rrruark/ESP32_Radiosonde/radiosonde_lite_final.pdf

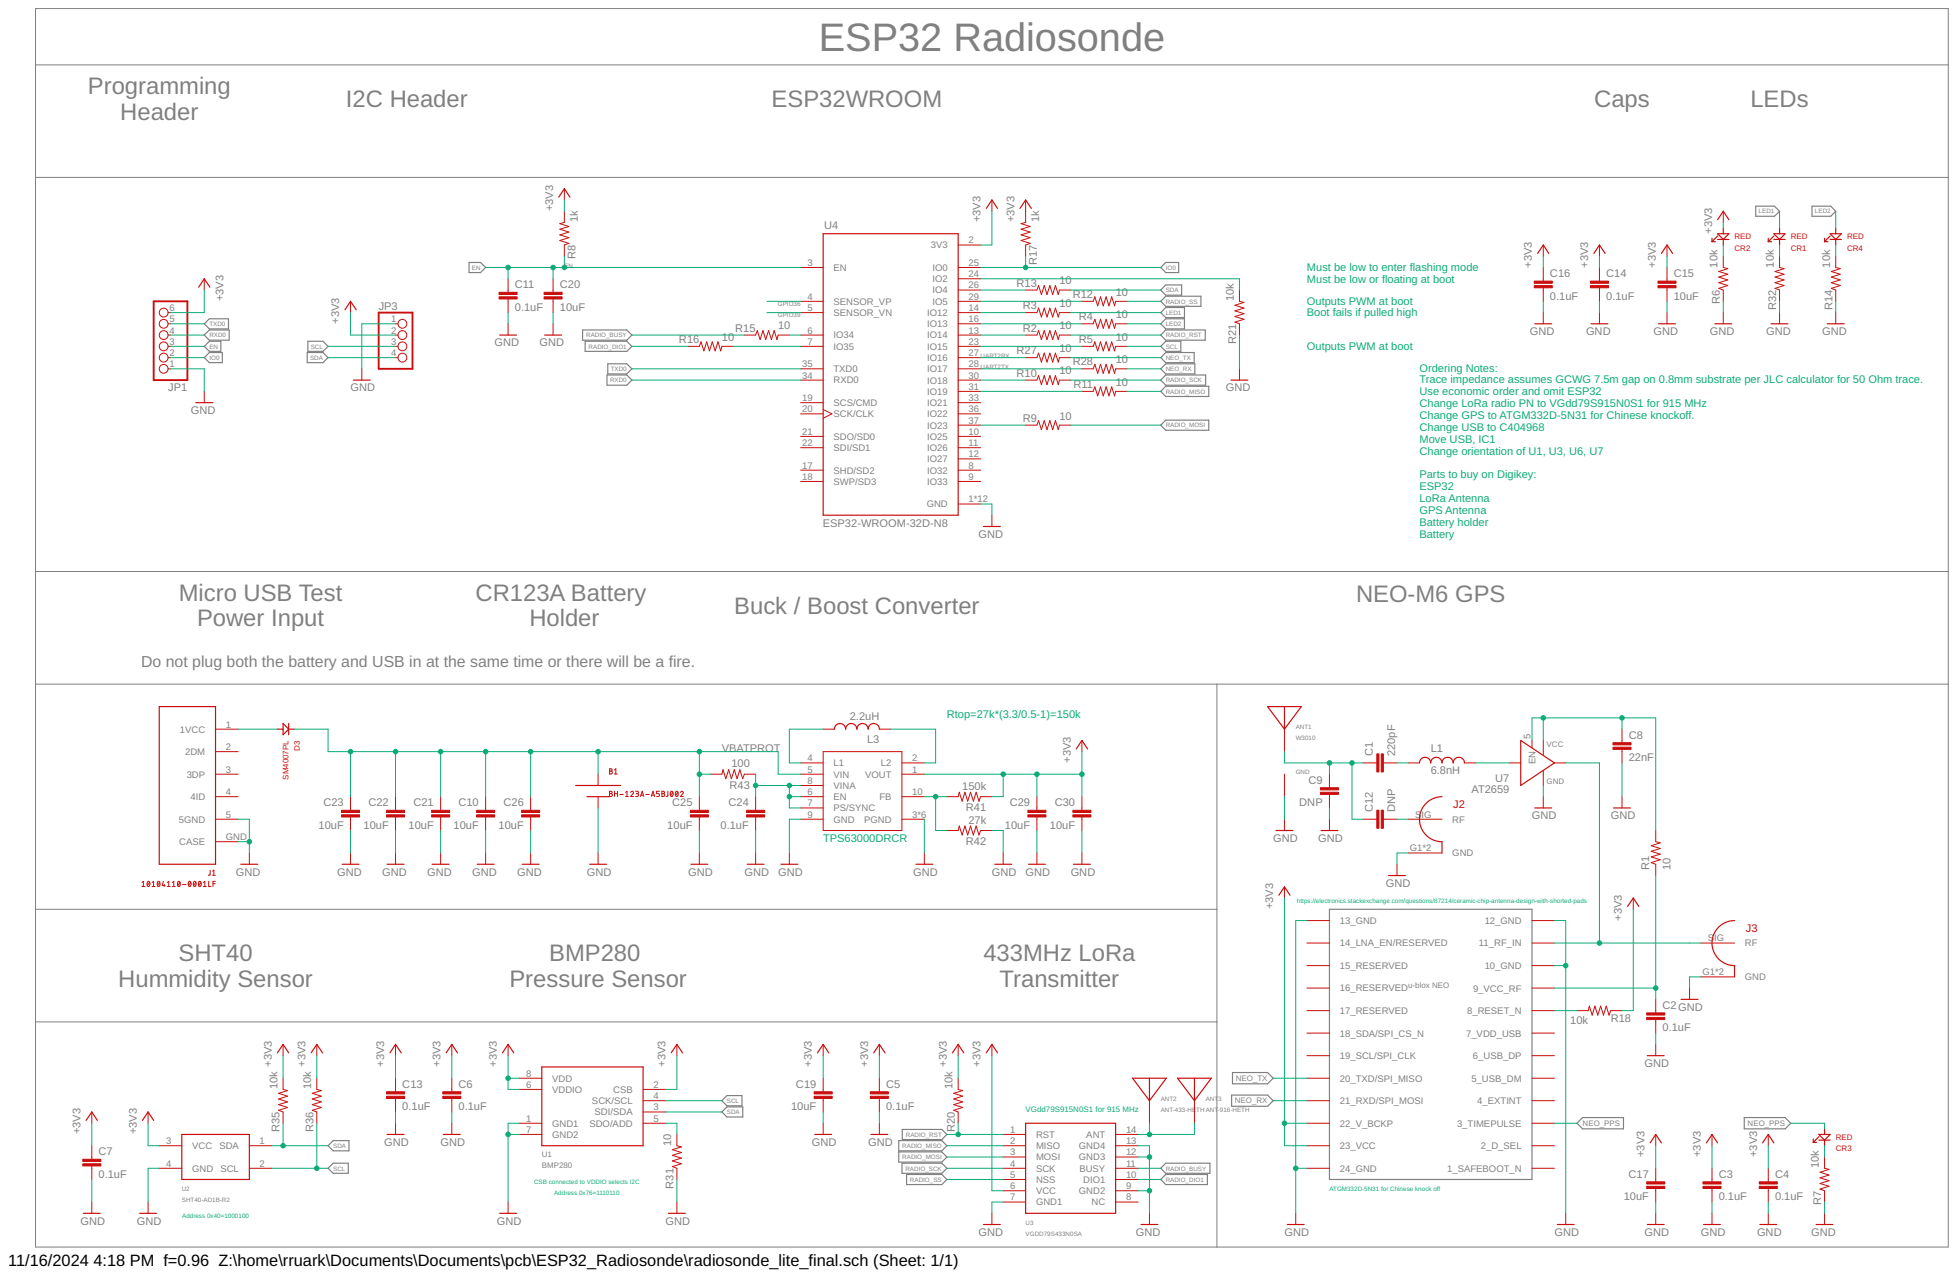
[picture p1: page 1]

Must be low or floating at boot Must be low to enter flashing mode Outputs PWM at boot Boot fails if pulled high

Outputs PWM at boot

Ordering Notes: Trace impedance assumes GCWG 7.5m gap on 0.8mm substrate per JLC calculator for 50 Ohm trace. Use economic order and omit ESP32

Change LoRa radio PN to VGdd79S915N0S1 for 915 MHz Change GPS to ATGM332D-5N31 for Chinese knockoff. Change USB to C404968

Parts to buy on Digikey: ESP32

LoRa Antenna GPS Antenna Battery holder Battery

Do not plug both the battery and USB in at the same time or there will be a fire.

https://electronics.stackexchange.com/questions/87214/ceramic-chip-antenna-design-with-shorted-pads

CSB connected to VDDIO selects I2C

ATGM332D-5N31 for Chinese knock off

11/16/2024 4:18 PM f=0.96 Z:\home\rruark\Documents\Documents\pcb\ESP32_Radiosonde\radiosonde_lite_final.sch (Sheet: 1/1)
