rrruark/ESP32_Radiosonde/PCB/radiosonde_lite.brd

## EAGLE design PCB/radiosonde_lite.brd (2024-10-17)

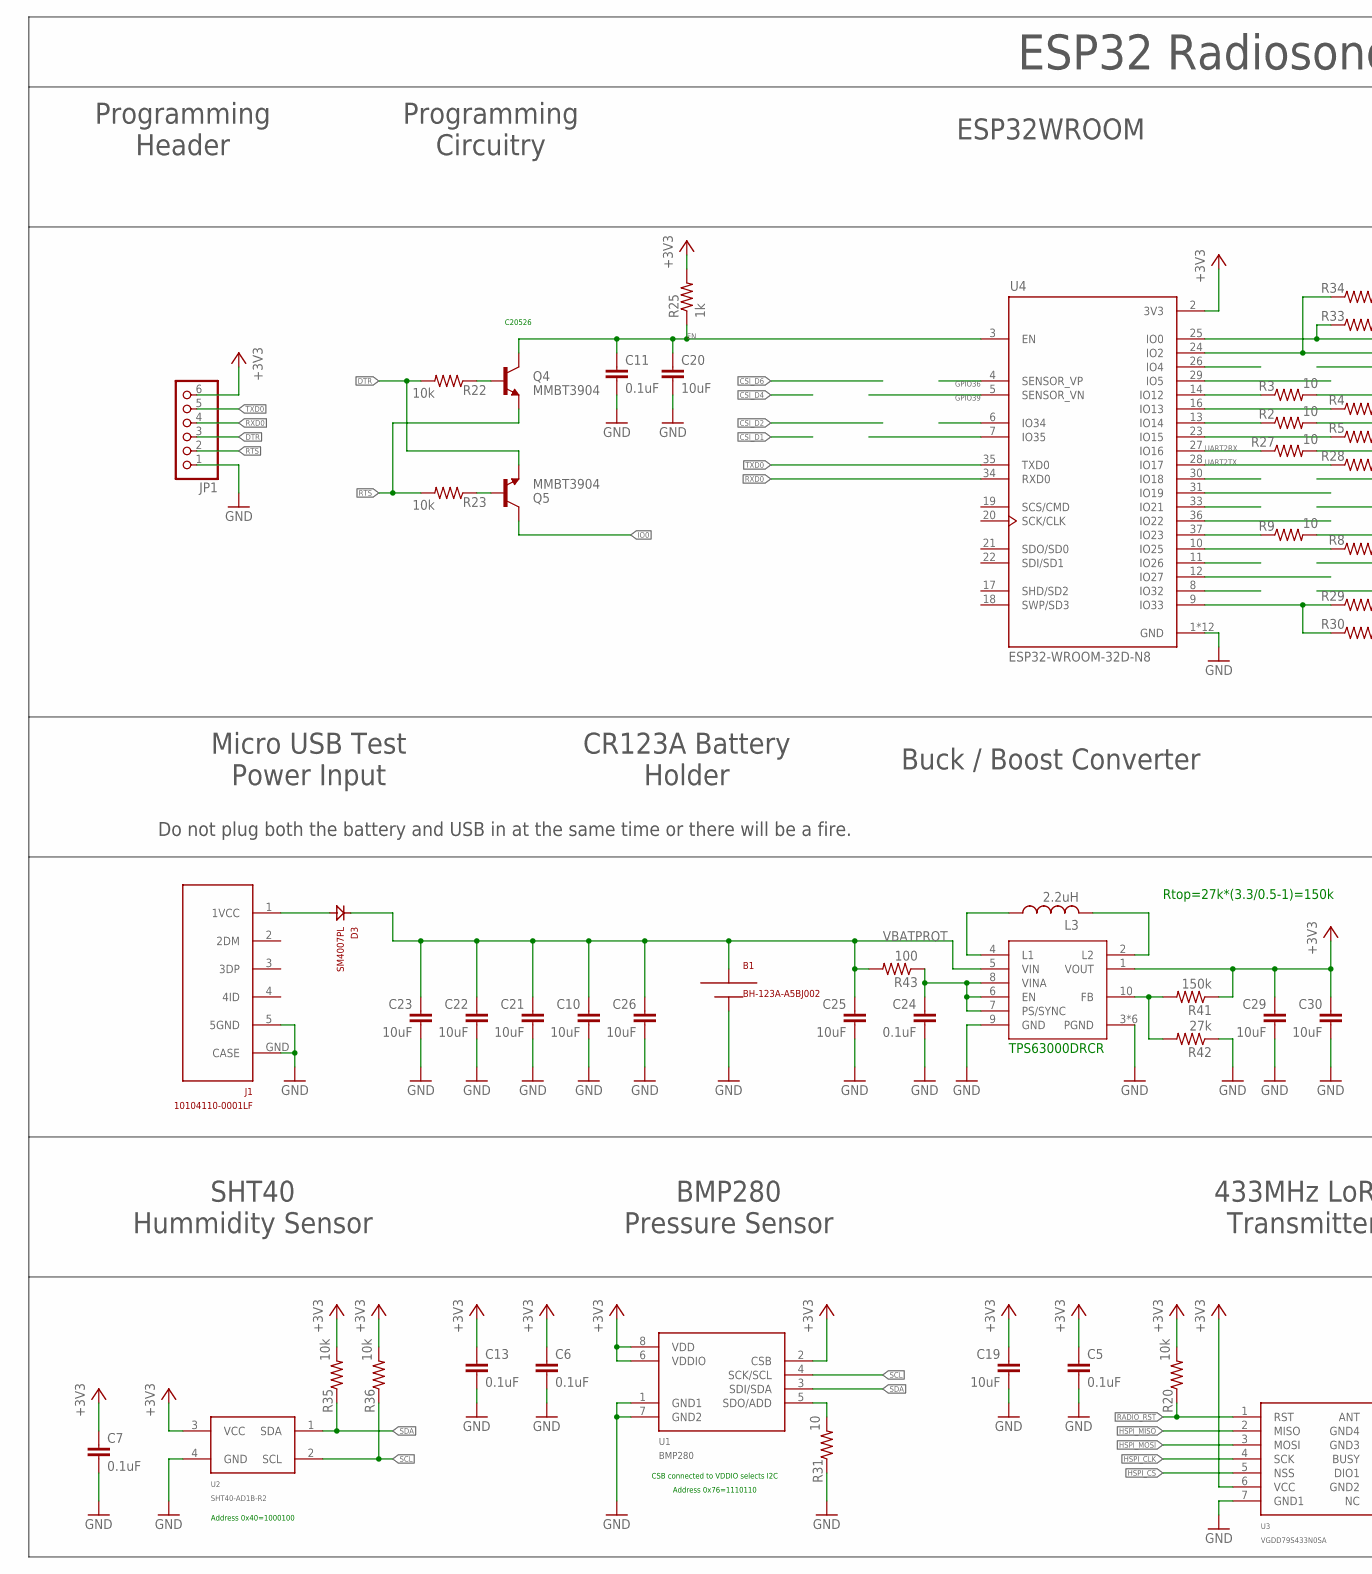
[picture p2: schematic radiosonde_lite.sch, part in row 1, column 1]

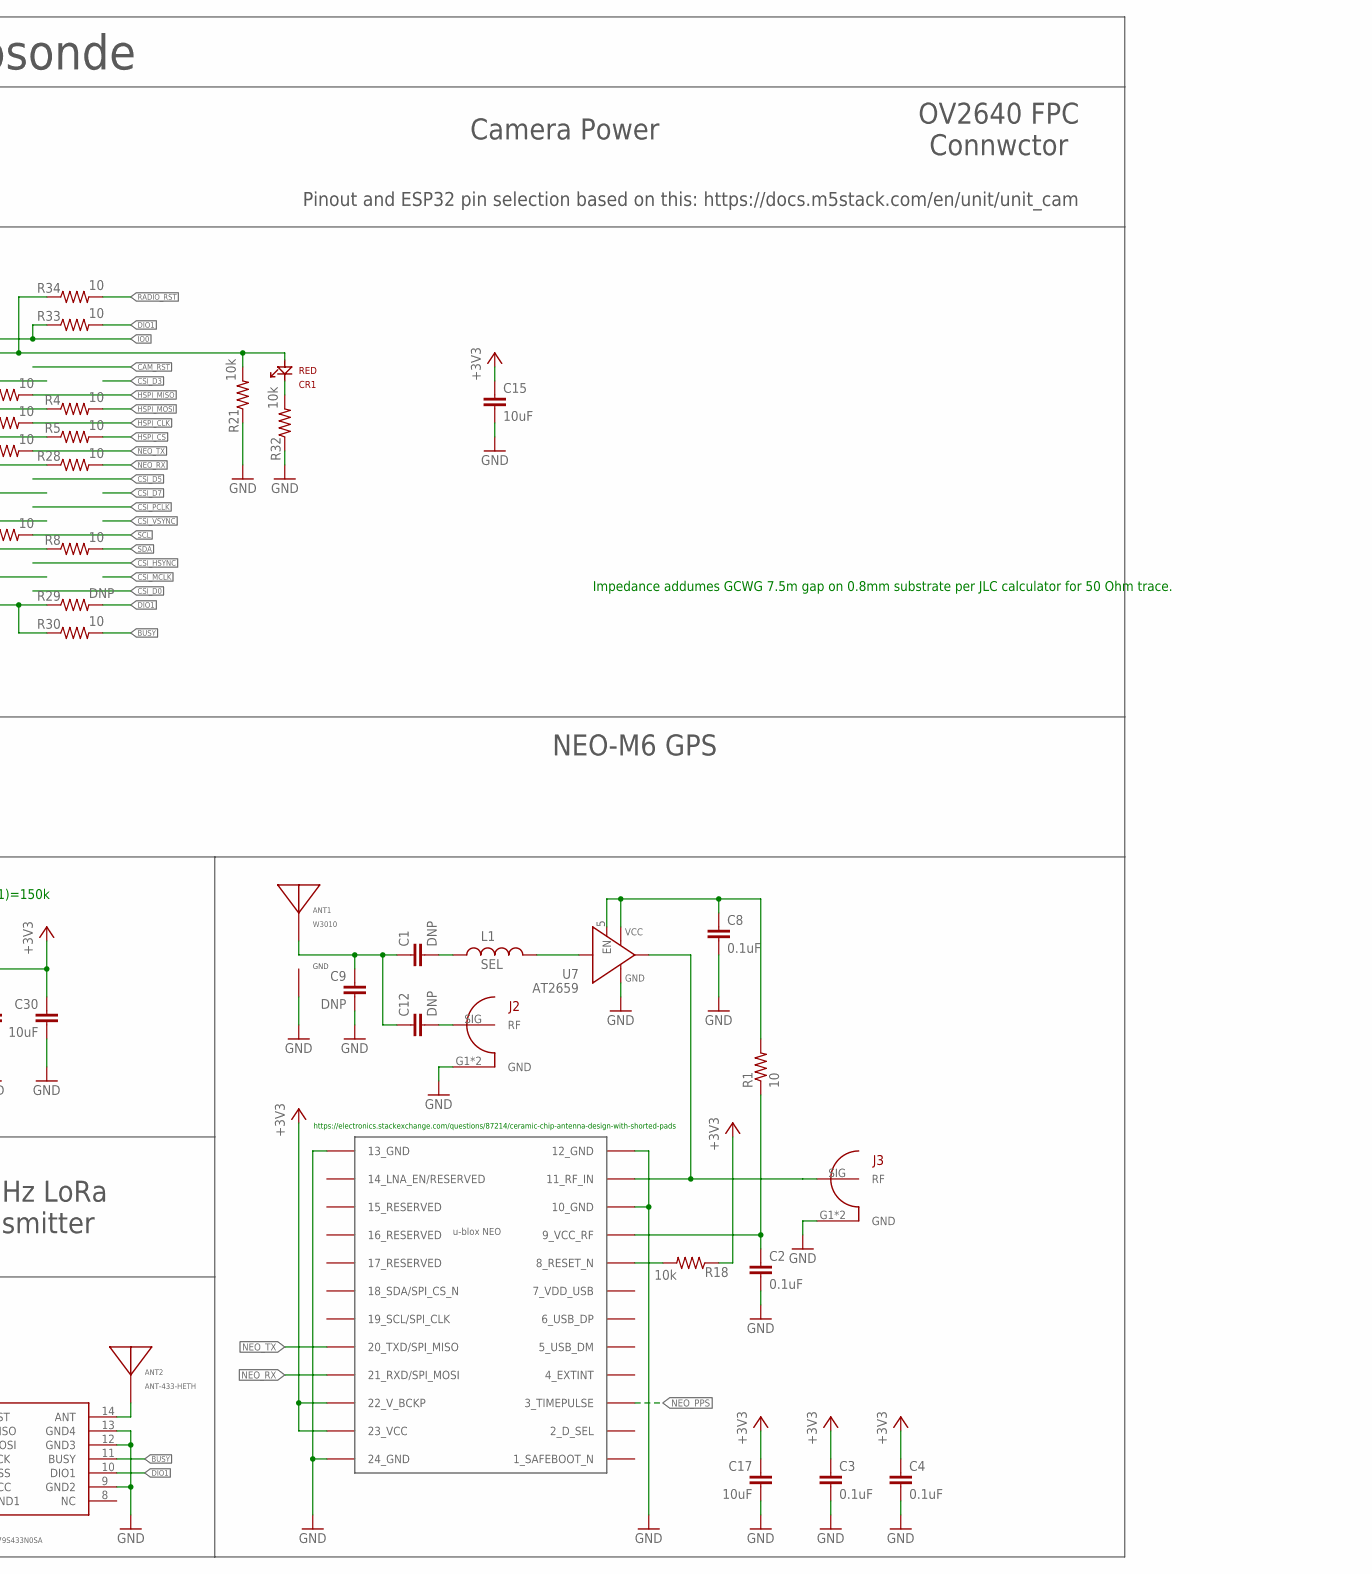
[picture p3: schematic radiosonde_lite.sch, part in row 1, column 2]

Parts:
ANT1: W3010
ANT2: ANT-433-HETH
B1: BH-123A-A5BJ002
C1, C9, C12: DNP; 0402_INDUCTOR
C2, C3, C4, C5, C6, C7, C8, C11, C13: 0.1uF; 0402_INDUCTOR
C10, C15, C17, C19, C20, C21, C22, C23, C25, C26, C29, C30: 10uF; 0603
C24: 0.1uF; 0603
CR1: RED; 0603_DIODE
D3: SM4007PL; SOD123(AK)
IC1: NEO-M8
J1: 10104110-0001LF; MICRO_USB
J2, J3: CONUFL001-SMD; U.FL
JP1: PINHD-1X6; 1X06
L1: SEL; 0402_INDUCTOR
L3: 2.2uH; CY43
Q4, Q5: MMBT3904; SOT23-3_CENTERED
R1, R2, R3, R4, R5, R8, R9, R27, R28, R30, R31, R33, R34: 10; R0402
R18, R20, R21, R22, R23, R32, R35, R36: 10k; R0402
R25: 1k; 0603
R29: DNP; R0402
R41: 150k; 0603
R42: 27k; 0603
R43: 100; 0603
U1: BMP280; BME280
U2: SHT40-AD1B-R2; SHT40
U3: VGDD79S433N0SA
U4: ESP32-WROOM-32D-N8; MODULE_ESP32-WROOM-32D
U6: TPS63000DRCR; S-PVSON-N10
U7: AT2659; 6DFN-1X1.6

Connections:
+3V3: C3.P$1 (1), C4.P$1 (1), C5.P$1 (1), C6.P$1 (1), C7.P$1 (1), C13.P$1 (1), C15.1, C17.1, C19.1, C29.1, C30.1, IC1.22 (22_V_BCKP), IC1.23 (23_VCC), JP1.6, R18.1, R20.2, R25.2, R35.2, R36.2, R41.1, U1.2 (CSB), U1.6 (VDDIO), U1.8 (VDD), U2.3 (VCC), U3.6 (VCC), U4.2 (3V3), U6.1 (VOUT)
BUSY: R30.2, U3.11 (BUSY)
DIO1: R29.2, R33.2, U3.10 (DIO1)
DTR: JP1.3, Q5.2 (E), R22.2
EN: C11.P$1 (1), C20.1, Q4.3 (C), R25.1, U4.3 (EN)
GND: ANT1.P$1 (GND), ANT1.P$3 (GND), B1.N (-), C2.P$2 (2), C3.P$2 (2), C4.P$2 (2), C5.P$2 (2), C6.P$2 (2), C7.P$2 (2), C8.P$2 (2), C9.P$2 (2), C10.2, C11.P$2 (2), C13.P$2 (2), C15.2, C17.2, C19.2, C20.2, C21.2, C22.2, C23.2, C24.2, C25.2, C26.2, C29.2, C30.2, IC1.10 (10_GND), IC1.12 (12_GND), IC1.13 (13_GND), IC1.24 (24_GND), J1.5 (5GND), J1.GND (CASE), J2.G1 (GND), J2.G2 (GND), J3.G1 (GND), J3.G2 (GND), JP1.1, R21.1, R31.1, R32.1, R42.1, U1.1 (GND1), U1.7 (GND2), U2.4 (GND), U3.7 (GND1), U3.9 (GND2), U3.12 (GND3), U3.13 (GND4), U4.1 (GND), U4.15 (GND), U4.38 (GND), U4.39_1 (GND), U4.39_2 (GND), U4.39_3 (GND), U4.39_4 (GND), U4.39_5 (GND), U4.39_6 (GND), U4.39_7 (GND), U4.39_8 (GND), U4.39_9 (GND), U6.3 (PGND), U6.9 (GND), U6.PG (PGND), U6.PG1 (PGND), U6.PG2 (PGND), U6.PG3 (PGND), U6.PG4 (PGND), U7.1 (GND), U7.2 (GND)
GPIO36: U4.4 (SENSOR_VP)
GPIO39: U4.5 (SENSOR_VN)
GPS_VCC_RF: C8.P$1 (1), R1.2, U7.4 (VS), U7.5 (EN)
HSPI_CLK: R2.2, U3.4 (SCK)
HSPI_CS: R5.2, U3.5 (NSS)
HSPI_MISO: R3.2, U3.2 (MISO)
HSPI_MOSI: R4.2, U3.3 (MOSI)
IO0: Q5.3 (C), R33.1, U4.25 (IO0)
unnamed: R3.1, U4.14 (IO12)
unnamed: IC1.8 (8_RESET_N), R18.2
unnamed: C1.P$2 (2), L1.P$1
unnamed: R29.1, R30.1, U4.9 (IO33)
unnamed: L1.P$2, U7.3 (RF_IN)
unnamed: R4.1, U4.16 (IO13)
unnamed: R31.2, U1.5 (SDO/ADD)
unnamed: ANT2.IN1, ANT2.IN2, U3.14 (ANT)
unnamed: R5.1, U4.23 (IO15)
unnamed: ANT1.P$2 (ANT), C1.P$1 (1), C9.P$1 (1), C12.P$1 (1)
unnamed: CR1.K, R32.2
unnamed: R9.1, U4.37 (IO23)
unnamed: R8.1, U4.10 (IO25)
unnamed: Q4.1 (B), R22.1
unnamed: D3.A, J1.1 (1VCC)
unnamed: C2.P$1 (1), IC1.9 (9_VCC_RF), R1.1
unnamed: Q5.1 (B), R23.1
unnamed: CR1.A, R21.2, R34.1, U4.24 (IO2)
unnamed: R2.1, U4.13 (IO14)
unnamed: C12.P$2 (2), J2.SIG (RF)
unnamed: IC1.11 (11_RF_IN), J3.SIG (RF), U7.6 (RF_OUT)
unnamed: L3.P$1 (1), U6.4 (L1)
unnamed: L3.P$2 (2), U6.2 (L2)
unnamed: R41.2, R42.2, U6.10 (FB)
unnamed: C24.1, R43.1, U6.6 (EN), U6.7 (PS/SYNC), U6.8 (VINA)
NEO_PPS: IC1.3 (3_TIMEPULSE)
NEO_RX: IC1.21 (21_RXD/SPI_MOSI), R28.2
NEO_TX: IC1.20 (20_TXD/SPI_MISO), R27.2
RADIO_RST: R20.1, R34.2, U3.1 (RST)
RTS: JP1.2, Q4.2 (E), R23.2
RXD0: JP1.4, U4.34 (RXD0)
SCL: R9.2, R36.1, U1.4 (SCK/SCL), U2.2 (SCL)
SDA: R8.2, R35.1, U1.3 (SDI/SDA), U2.1 (SDA)
TXD0: JP1.5, U4.35 (TXD0)
UART2RX: R27.1, U4.27 (IO16)
UART2TX: R28.1, U4.28 (IO17)
VBATPROT: B1.P (+), C10.1, C21.1, C22.1, C23.1, C25.1, C26.1, D3.K, R43.2, U6.5 (VIN)

Notes on the sheet:
TPS63000DRCR
Rtop=27k*(3.3/0.5-1)=150k
https://electronics.stackexchange.com/questions/87214/ceramic-chip-antenna-design-with-shorted-pads
CSB connected to VDDIO selects I2C
Address 0x76=1110110
Address 0x40=1000100
ESP32 Radiosonde
Programming Header
Programming Circuitry
ESP32WROOM
Camera Power
OV2640 FPC Connwctor
Buck / Boost Converter
NEO-M6 GPS
433MHz LoRa Transmitter
BMP280 Pressure Sensor
SHT40 Hummidity Sensor
CR123A Battery Holder
Micro USB Test Power Input
Do not plug both the battery and USB in at the same time or there will be a fire.
Pinout and ESP32 pin selection based on this: https://docs.m5stack.com/en/unit/unit_cam
C20526
Impedance addumes GCWG 7.5m gap on 0.8mm substrate per JLC calculator for 50 Ohm trace.

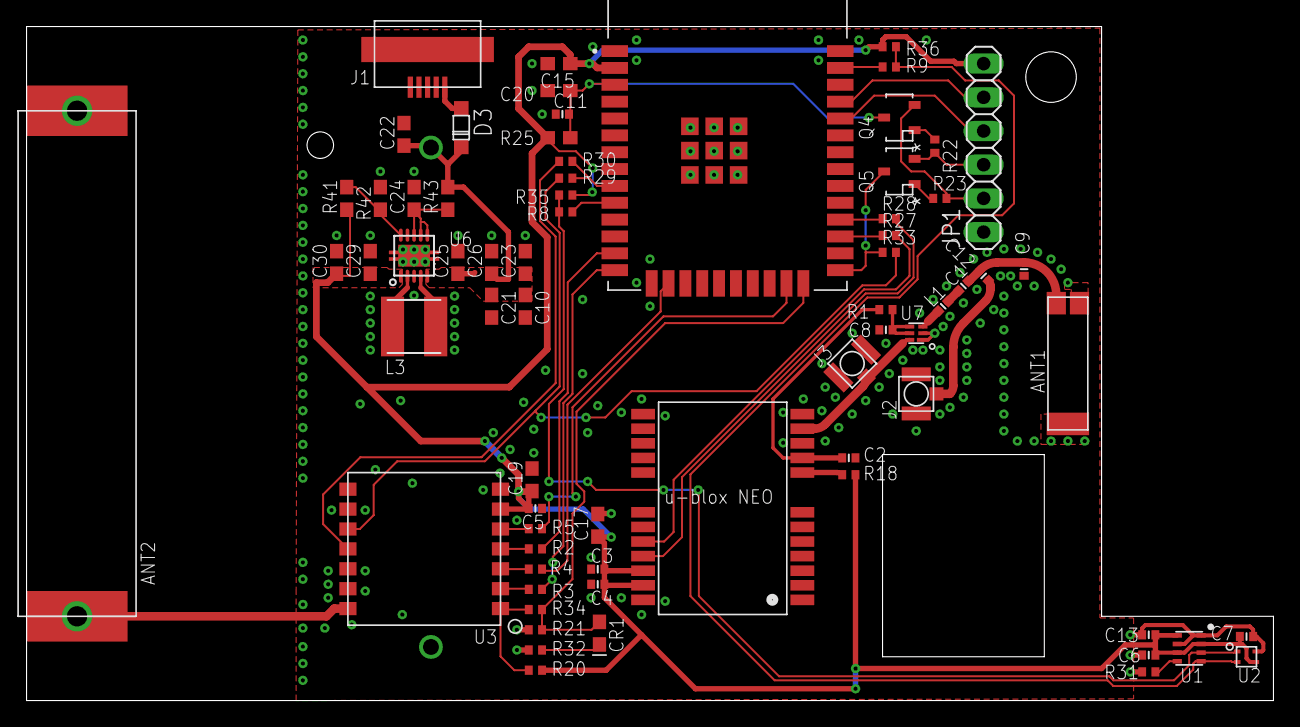
[picture p4: board radiosonde_lite.brd from above]

Board: 2 copper layers, 94.0 x 50.8 mm, 71 parts (1 on the bottom side), 48 nets.
