rrruark/ESP32_Radiosonde/(commit log)

2024-05-19 Initial Commit
    Ready for schematic review
    [radiosonde.brd, radiosonde.sch]
2024-11-14 adding arduino code
2024-12-13 Added Arduino sketches
    [radiosonde.brd, radiosonde.sch, radiosonde_lite.brd, radiosonde_lite.sch, radiosonde_lite_final.brd, radiosonde_lite_final.sch, radiosonde_lite_final_top_bom.csv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]
